satoshinji2992/servo/Core/Src/main.c

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
/* Includes ------------------------------------------------------------------*/
#include "main.h"
#include "tim.h"
#include "usart.h"
#include "gpio.h"

/* USER CODE BEGIN Includes */
#include <stdio.h>
#include <string.h>
#include <stdlib.h>
#include "jy61.h"
#include "gimbal.h"
/* USER CODE END Includes */


/* USER CODE BEGIN PV */
// 串口交互变量
uint8_t rx_buffer[32];
uint8_t rx_index = 0;
uint8_t packet_ready = 0;
uint8_t rx_byte;

// 协议状态机
typedef enum
{
    STATE_WAIT_HEADER1,
    STATE_WAIT_HEADER2,
    STATE_WAIT_LEN,
    STATE_WAIT_DATA,
    STATE_WAIT_CHECKSUM
} ProtocolState;

static ProtocolState g_rx_state = STATE_WAIT_HEADER1;
static uint8_t g_data_len = 0;
static uint8_t g_checksum = 0;
/* USER CODE END PV */

void SystemClock_Config(void);
/* USER CODE BEGIN PFP */
void process_uart_packet(void);
void parse_protocol_packet(uint8_t *data, uint16_t len);
extern TIM_HandleTypeDef htim2;
extern UART_HandleTypeDef huart1;
extern UART_HandleTypeDef huart2;
/* USER CODE END PFP */

/* USER CODE BEGIN 0 */

void process_uart_packet(void)
{
    if (packet_ready)
    {
        HAL_UART_AbortReceive_IT(&huart1);
        parse_protocol_packet(rx_buffer, g_data_len);
        rx_index = 0;
        packet_ready = 0;
        g_rx_state = STATE_WAIT_HEADER1;
        HAL_UART_Receive_IT(&huart1, &rx_byte, 1);
    }
}

void parse_protocol_packet(uint8_t *data, uint16_t len)
{
    double delta_x = 0, delta_y = 0;
    memcpy(&delta_x, &data[0], sizeof(double));
    memcpy(&delta_y, &data[8], sizeof(double));

    if (delta_x == 500.0 && delta_y == 500.0)
    {
        HAL_GPIO_WritePin(GPIOA, Laser_Pin, GPIO_PIN_RESET);
        return;
    }

    double new_upper = upper_angle + delta_y;
    double new_lower = lower_angle + delta_x;

    if (new_upper < 0)
        new_upper = 0;
    if (new_upper > 270)
        new_upper = 270;

    upper_angle = new_upper;
    servo_set_upper_angle(upper_angle);
    servo_set_lower_angle(new_lower);

    HAL_GPIO_TogglePin(GPIOC, GPIO_PIN_13);
}

void HAL_UART_RxCpltCallback(UART_HandleTypeDef *huart)
{
    if (huart->Instance == USART1)
    {
        switch (g_rx_state)
        {
        case STATE_WAIT_HEADER1:
            if (rx_byte == 0xAA)
                g_rx_state = STATE_WAIT_HEADER2;
            break;
        case STATE_WAIT_HEADER2:
            if (rx_byte == 0xBB)
                g_rx_state = STATE_WAIT_LEN;
            else
                g_rx_state = STATE_WAIT_HEADER1;
            break;
        case STATE_WAIT_LEN:
            g_data_len = rx_byte;
            if (g_data_len > 0 && g_data_len <= sizeof(rx_buffer))
            {
                rx_index = 0;
                g_checksum = 0;
                g_rx_state = STATE_WAIT_DATA;
            }
            else
            {
                g_rx_state = STATE_WAIT_HEADER1;
            }
            break;
        case STATE_WAIT_DATA:
            rx_buffer[rx_index++] = rx_byte;
            if (rx_index >= g_data_len)
            {
                g_rx_state = STATE_WAIT_CHECKSUM;
            }
            break;
        case STATE_WAIT_CHECKSUM:
            {
                uint8_t sum = 0;
                for (uint8_t i = 0; i < g_data_len; i++)
                    sum += rx_buffer[i];
                if (sum == rx_byte)
                    packet_ready = 1;
                g_rx_state = STATE_WAIT_HEADER1;
            }
            break;
        }
        HAL_UART_Receive_IT(&huart1, &rx_byte, 1);
    }
    else if (huart->Instance == USART2)
    {
        jy61_receive_data(rx_byte_jy61);
        HAL_UART_Receive_IT(&huart2, &rx_byte_jy61, 1);
    }
}
/* USER CODE END 0 */

/**
 * @brief  The application entry point.
 * @retval int
 */
int main(void)
{
    /* MCU Configuration--------------------------------------------------------*/
    /* Reset of all peripherals, Initializes the Flash interface and the Systick. */
    HAL_Init();

    /* Configure the system clock */
    SystemClock_Config();

    /* Initialize all configured peripherals */
    MX_GPIO_Init();
    MX_TIM2_Init();
    MX_USART1_UART_Init();
    MX_USART2_UART_Init();
    /* USER CODE BEGIN 2 */
    HAL_TIM_PWM_Start(&htim2, TIM_CHANNEL_1);
    HAL_TIM_PWM_Start(&htim2, TIM_CHANNEL_2);
    HAL_TIM_PWM_Start(&htim2, TIM_CHANNEL_3);

    jy61_init();
    servo_set_upper_angle(upper_angle);

    HAL_UART_Receive_IT(&huart1, &rx_byte, 1);
    HAL_UART_Receive_IT(&huart2, &rx_byte_jy61, 1);

    char welcome[] = "Protocol Parser Ready\r\n";
    HAL_UART_Transmit(&huart1, (uint8_t *)welcome, strlen(welcome), 1000);

    stepper1_enable(1);
    /* USER CODE END 2 */

    /* Infinite loop */
    /* USER CODE BEGIN WHILE */
    while (1)
    {
        /* USER CODE BEGIN 3 */
        process_uart_packet();
    }
    /* USER CODE END 3 */
}

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
