satoshinji2992/servo/Core/Inc/main.h

#define LED_Pin GPIO_PIN_13
#define LED_GPIO_Port GPIOC
#define Dir1_Pin GPIO_PIN_4
#define Dir1_GPIO_Port GPIOA
#define Stp1_Pin GPIO_PIN_5
#define Stp1_GPIO_Port GPIOA
#define En1_Pin GPIO_PIN_6
#define En1_GPIO_Port GPIOA
#define Laser_Pin GPIO_PIN_7
#define Laser_GPIO_Port GPIOA
