satoshinji2992/servo/(commit log)

2025-07-20 把angle改成了uint16_t
2025-07-20 增加上位机控制
2025-07-21 完全版1.0.0
2025-07-21 完全版1.0.1,增加视觉模块的hsv触摸调参
2025-07-22 1.1.0 增加红色激光追踪绿色激光
2025-07-30 1.2.0 步进电机舵机联合云台,double精度控制
2025-07-31 1.2.2 用陀螺仪稳定转弯时的云台,完成瞄准追踪任务切换,实时校准激光和画面中心偏移像素
2025-08-01 1.3.0 视觉从maixcam转到树莓派,完善打靶追踪切换,pid待细调
2026-04-07 整理代码
2026-04-07 整理仓库
